amalnathkp13-boop/vergelink/kicad/VergeLink_Mainboard_BOM.csv

Refs | Value | Footprint | Qty | DNP
C1 | 1uF X7R |  | 1
C2 | 1uF X7R |  | 1
C3 | 10uF 25V |  | 1
C4 | 100nF |  | 1
C5 | 100nF |  | 1
C6 | 100nF |  | 1
C7 | 100nF |  | 1
D1 | Red 5mm STATUS |  | 1
J1 | USB 5V in (power bank) |  | 1
M1 | BioAmp EXG Pill - LEFT EOG |  | 1
M2 | BioAmp EXG Pill - RIGHT EOG |  | 1
M3 | Muscle BioAmp BisCute - JAW EMG |  | 1
M4 | VL53L5CX ToF breakout (forehead pod) |  | 1
M5 | MPU6500 GY-6500 IMU (forehead pod) |  | 1
R1 | 1k |  | 1
R2 | 1k |  | 1
R3 | 1k |  | 1
R4 | 330R |  | 1
SW1 | PSB-110 DISARM |  | 1
U1 | MCP1700T-3302E/TT |  | 1
U2 | ESP32-WROOM-32 DevKit (used pins) |  | 1
