amalnathkp13-boop/vergelink/cad/VergeLink_StrapLoop_FEA.FCStd

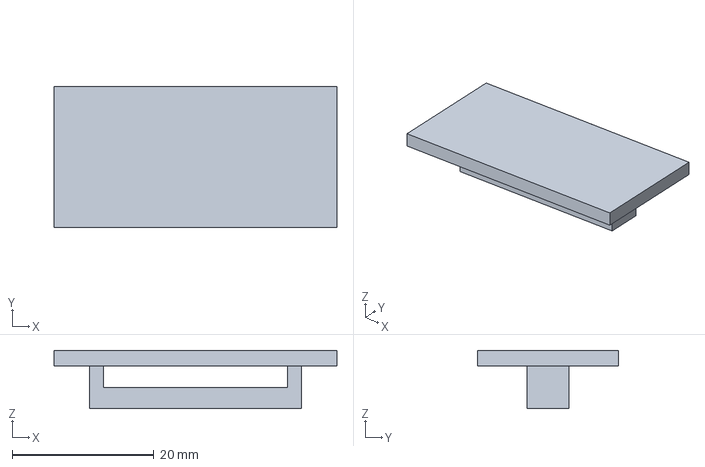
[picture p10: CAD file, 2026-10-14]
cad/VergeLink_StrapLoop_FEA.FCStd
40.0 x 20.0 x 8.20 mm
