amalnathkp13-boop/vergelink/cad/VergeLink_Enclosure.step

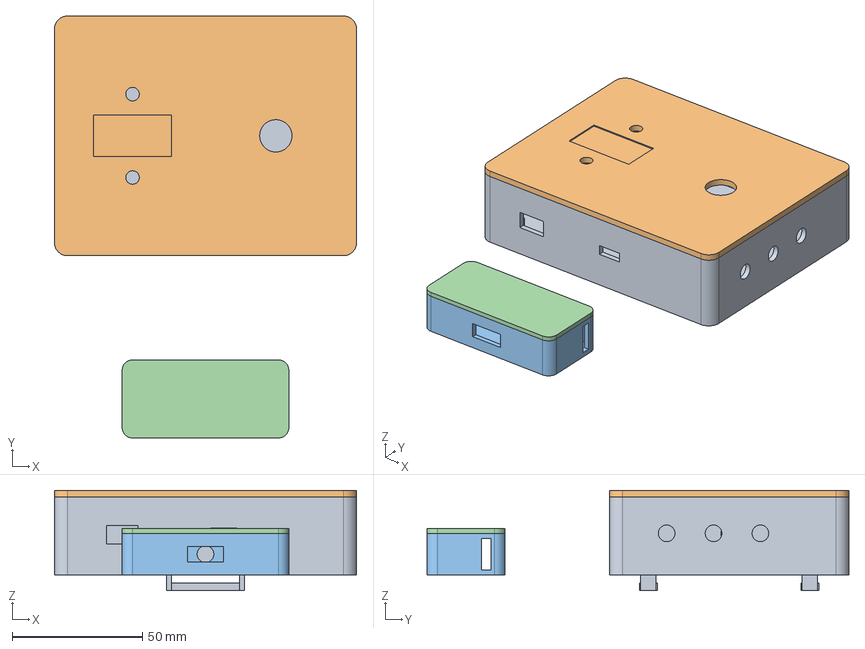
[picture p11: CAD file, 2026-10-14]
cad/VergeLink_Enclosure.step
116.0 x 162.0 x 38.5 mm
Enclosure_Base
Enclosure_Lid
Forehead_Pod
Forehead_Pod_Lid
