amalnathkp13-boop/vergelink/(list of files, cad)

Other CAD files:
cad/VergeLink_Enclosure.FCStd
