amalnathkp13-boop/vergelink/kicad/VergeLink_Mainboard_schematic.pdf

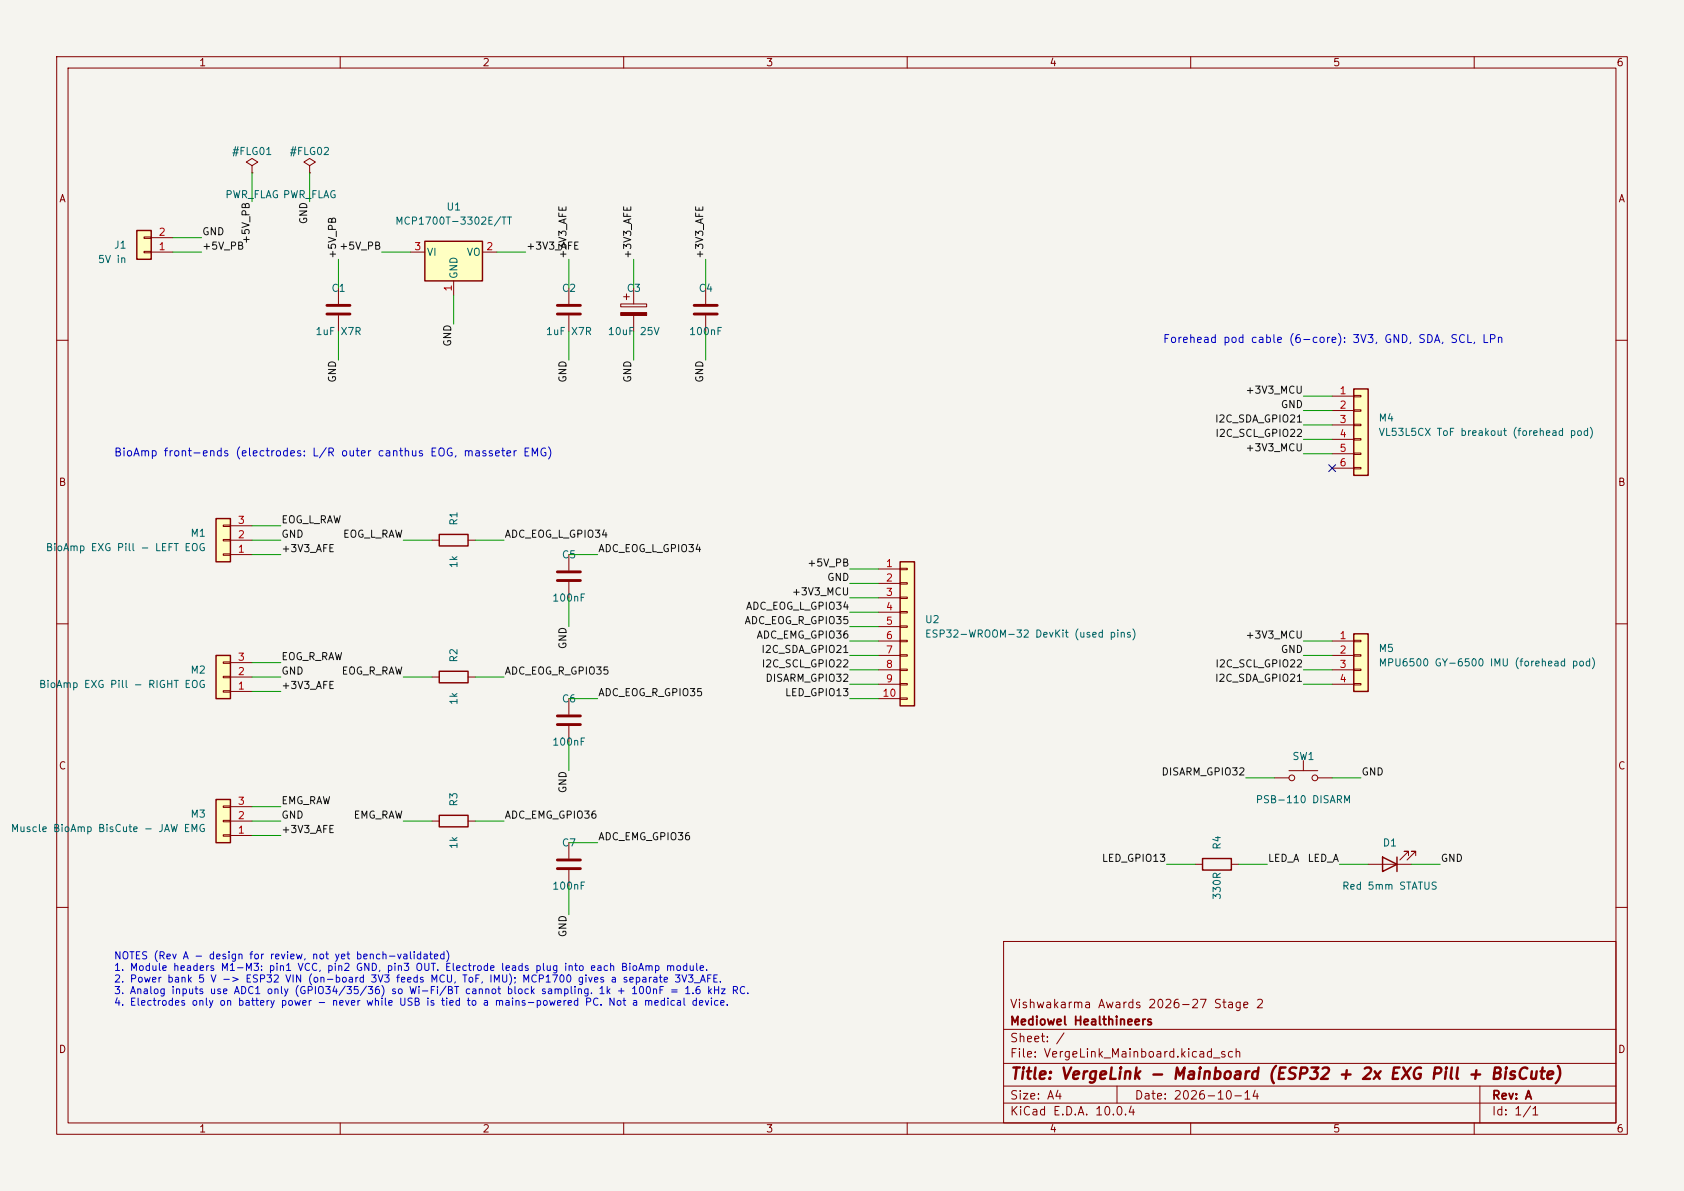
[picture p12: page 1]

VL53L5CX ToF breakout (forehead pod) R4 330R
I2C_SCL_GPIO22

3 M1 BioAmp EXG Pill - LEFT EOG

ESP32-WROOM-32 DevKit (used pins)

3 M3 Muscle BioAmp BisCute - JAW EMG

Vishwakarma Awards 2026-27 Stage 2
Mediowel Healthineers
Sheet: /
File: VergeLink_Mainboard.kicad_sch
Title: VergeLink - Mainboard (ESP32 + 2x EXG Pill + BisCute)

Size: A4 | Rev: A
KiCad E.D.A. 10.0.4 | Id: 1/1
