amalnathkp13-boop/vergelink/kicad/VergeLink_Mainboard.kicad_sch

## KiCad design kicad/VergeLink_Mainboard.kicad_sch (2026-10-14)

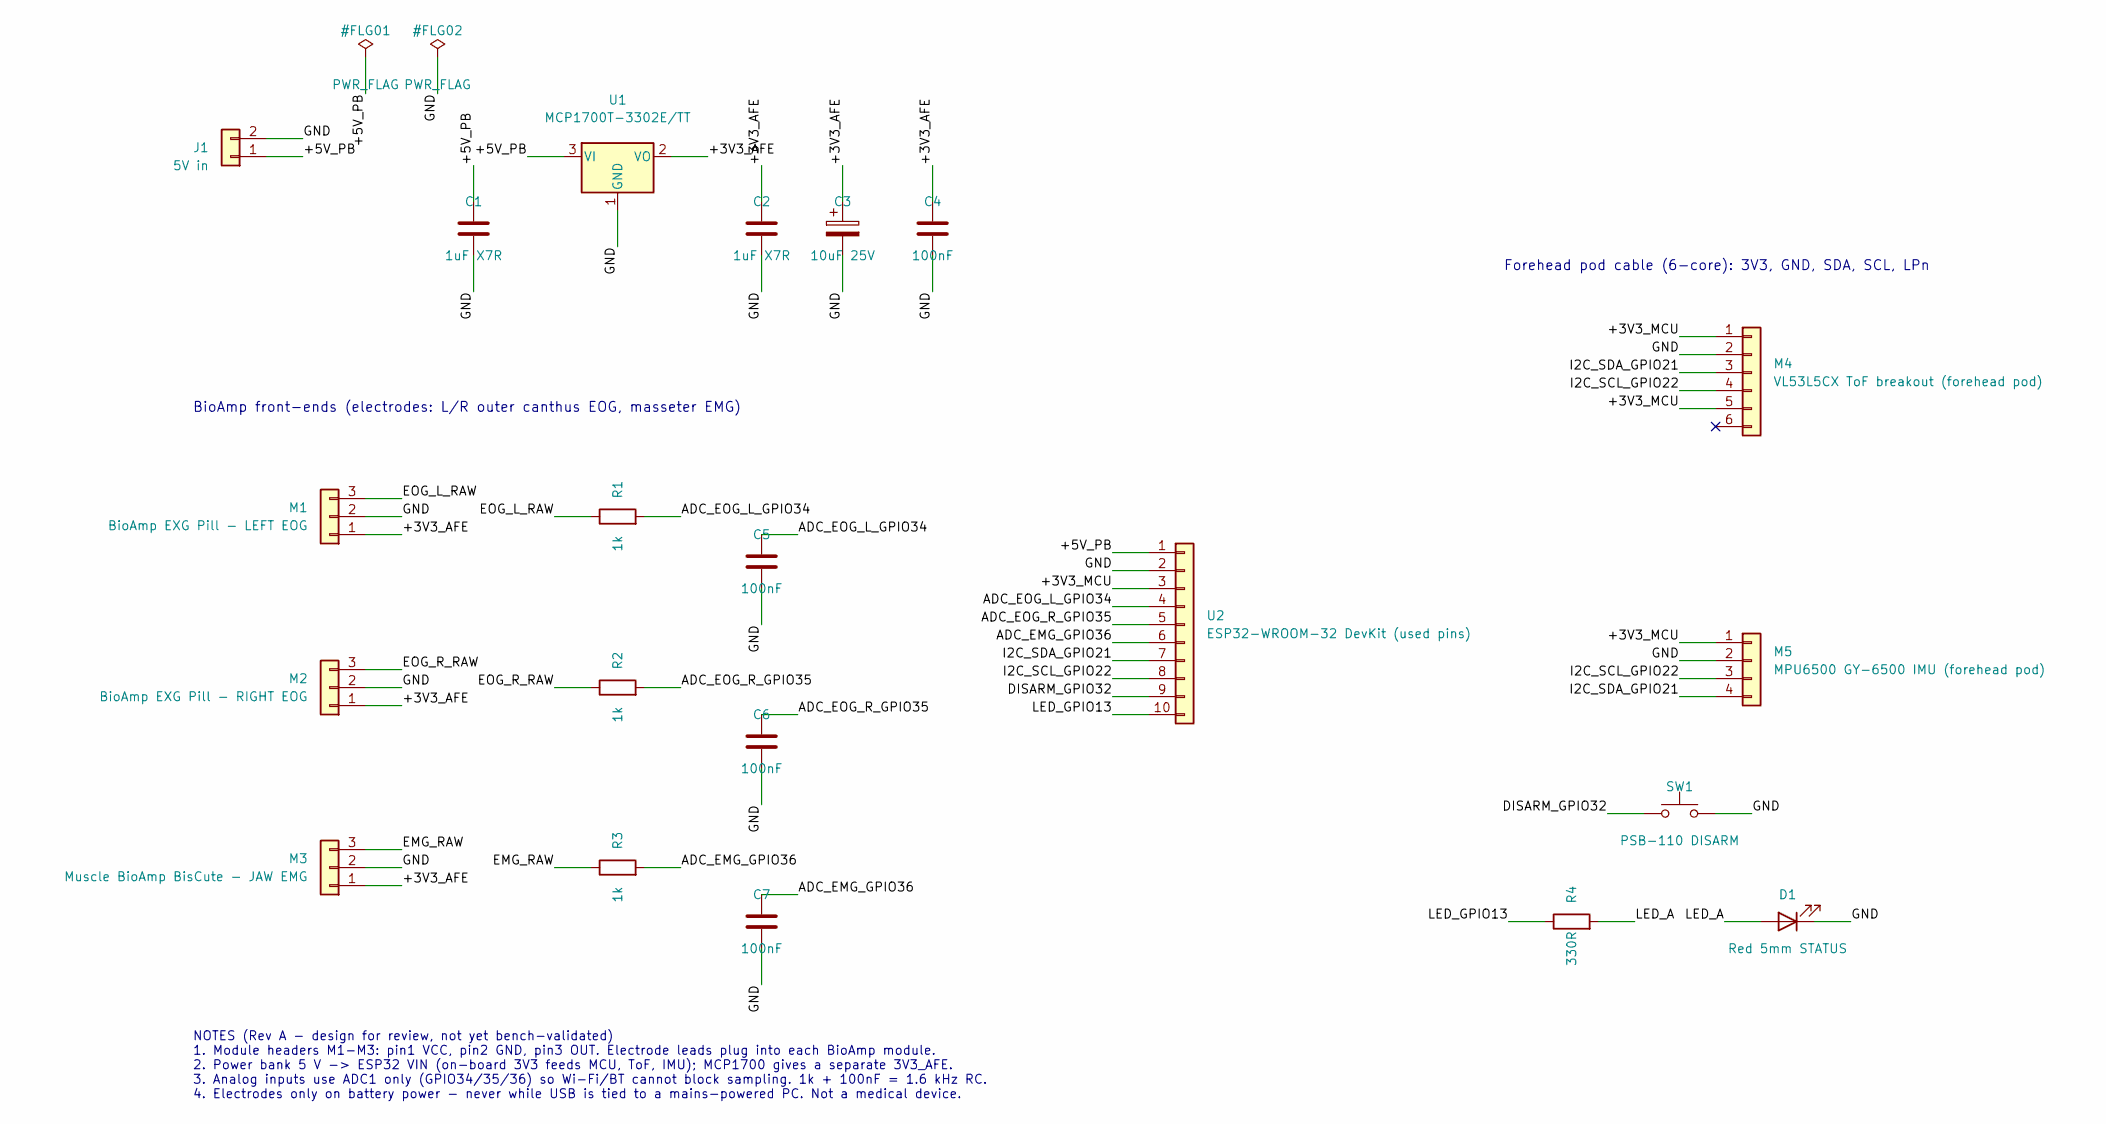
[picture p13: schematic VergeLink_Mainboard.kicad_sch]

Parts:
C1, C2: 1uF X7R
C3: 10uF 25V
C4, C5, C6, C7: 100nF
D1: Red 5mm STATUS
J1: 5V in
M1: BioAmp EXG Pill - LEFT EOG
M2: BioAmp EXG Pill - RIGHT EOG
M3: Muscle BioAmp BisCute - JAW EMG
M4: VL53L5CX ToF breakout (forehead pod)
M5: MPU6500 GY-6500 IMU (forehead pod)
R1, R2, R3: 1k
R4: 330R
SW1: PSB-110 DISARM
U1: MCP1700T-3302E/TT
U2: ESP32-WROOM-32 DevKit (used pins)

Connections:
+3V3_AFE: C2.1, C3.1, C4.1, M1.1, M2.1, M3.1, U1.2 (VO)
+3V3_MCU: M4.1, M4.5, M5.1, U2.3
+5V_PB: C1.1, J1.1, U1.3 (VI), U2.1
ADC_EMG_GPIO36: C7.1, R3.2, U2.6
ADC_EOG_L_GPIO34: C5.1, R1.2, U2.4
ADC_EOG_R_GPIO35: C6.1, R2.2, U2.5
DISARM_GPIO32: SW1.1, U2.9
EMG_RAW: M3.3, R3.1
EOG_L_RAW: M1.3, R1.1
EOG_R_RAW: M2.3, R2.1
GND: C1.2, C2.2, C3.2, C4.2, C5.2, C6.2, C7.2, D1.1 (K), J1.2, M1.2, M2.2, M3.2, M4.2, M5.2, SW1.2, U1.1 (GND), U2.2
I2C_SCL_GPIO22: M4.4, M5.3, U2.8
I2C_SDA_GPIO21: M4.3, M5.4, U2.7
LED_A: D1.2 (A), R4.2
LED_GPIO13: R4.1, U2.10

Notes on the sheet:
BioAmp front-ends (electrodes: L/R outer canthus EOG, masseter EMG)
Forehead pod cable (6-core): 3V3, GND, SDA, SCL, LPn
NOTES (Rev A - design for review, not yet bench-validated) 1. Module headers M1-M3: pin1 VCC, pin2 GND, pin3 OUT. Electrode leads plug into each BioAmp module. 2. Power bank 5 V -> ESP32 VIN (on-board 3V3 feeds MCU, ToF, IMU); MCP1700 gives a separate 3V3_AFE. 3. Analog inputs use ADC1 only (GPIO34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
